Neural-Nexus-IoTrix-2-0/intellicane/hardware/README.md

# Hardware documentation

- [Circuit reference](circuit_diagram.png): C3 pin mapping, required Echo divider, module power and common ground. Confirm actual hardware matches it.
- [Wiring](wiring.md): electrical requirements for the bench prototype.
- [BOM](BOM.md): recorded component costs and future estimates.

The team reports the basic hardware is connected. An enclosure, PCB fabrication files, battery-runtime measurements and physical test records are not supplied here. Do not treat the schematic as evidence that the pictured protection circuitry has already been installed.
