Neural-Nexus-IoTrix-2-0/intellicane/docs/proposals/IntelliCane_Project_Proposal.tex

\documentclass[10pt,a4paper]{article}
\usepackage[utf8]{inputenc}
\usepackage[margin=0.6in,top=0.6in,bottom=0.6in]{geometry}
\usepackage{amsmath}
\usepackage{amssymb}
\usepackage{xcolor}
\usepackage{hyperref}
\usepackage{booktabs}
\usepackage{tabularx}
\usepackage{enumitem}
\usepackage{titlesec}
\usepackage{fancyhdr}
\usepackage{mathptmx}

% Colors
\definecolor{primary}{RGB}{24, 76, 120}     % Navy Blue
\definecolor{secondary}{RGB}{41, 128, 185}  % Slate Blue
\definecolor{darkgray}{RGB}{50, 50, 50}
\definecolor{lightgray}{RGB}{245, 247, 250}

% Hyperref setup
\hypersetup{
    colorlinks=true,
    linkcolor=primary,
    urlcolor=secondary,
    citecolor=primary
}

% Section formatting
\titleformat{\section}{\large\bfseries\color{primary}}{}{0em}{}[\titlerule]
\titlespacing*{\section}{0pt}{7pt}{3pt}
\titleformat{\subsection}{\normalsize\bfseries\color{secondary}}{}{0em}{}
\titlespacing*{\subsection}{0pt}{4pt}{2pt}

% Headers and Footers
\pagestyle{fancy}
\fancyhf{}
\lhead{\footnotesize\textcolor{darkgray}{\textbf{IoTrix 2.0} $|$ Track A: Embedded IoT System}}
\rhead{\footnotesize\textcolor{darkgray}{Team: \textbf{Neural-Nexus} $|$ IntelliCane}}
\lfoot{\footnotesize\textcolor{darkgray}{\href{https://github.com/Neural-Nexus-IoTrix-2-0/intellicane}{github.com/Neural-Nexus-IoTrix-2-0/intellicane}}}
\rfoot{\footnotesize\textcolor{darkgray}{Page \thepage}}
\renewcommand{\headrulewidth}{0.4pt}
\renewcommand{\footrulewidth}{0.4pt}

\setlist{nosep, leftmargin=1.5em}

\begin{document}

% Header Block
\begin{center}
    {\LARGE \textbf{\color{primary} IntelliCane}} \\[0.3em]
    {\large \textbf{Smart Assistive White Cane with Haptic Obstacle Avoidance, Fall Detection, \\ and Companion Mobile App with Caretaker Push Alerts}} \\[0.5em]
    \small
    \textbf{Team Neural-Nexus} \quad$|$\quad \textbf{Track A: Embedded IoT System Development} \quad$|$\quad \textbf{IoTrix 2.0} \\
    \textbf{Members:} Dulnith Liyanage, Thenul Sahansa, Chamith Chethana, Suneth Vidurasa \\
    \textbf{Repository:} \url{https://github.com/Neural-Nexus-IoTrix-2-0/intellicane} \quad$|$\quad \textbf{Submission Date:} 5 October 2026
\end{center}
\vspace{-0.5em}
\hrule height 1pt
\vspace{0.5em}

% Section 1
\section{1. The Problem: Why We Built IntelliCane}
A traditional white cane is great for finding steps and curbs on the ground, but visually impaired people frequently bump into waist- and head-level hazards---such as open car doors, low tree branches, or protruding tables. Worse still, if a user trips, falls, or drops their cane, they can easily get hurt and isolated without any way to call for help. Commercial electronic smart canes attempt to solve this, but they usually cost upwards of \$500 (LKR 150,000+), depend heavily on constant internet connections just to detect hazards, and constantly blast annoying beeps into the user's ears, drowning out vital ambient traffic sounds.

As an undergraduate engineering team, we built \textbf{IntelliCane} to solve these real-world issues directly. For a bench electronics cost of just LKR 2,800, IntelliCane pairs an instant offline hardware reflex on the cane with an accessible Android companion app that keeps caretakers alerted without getting in the user's way.

% Section 2
\section{2. Proposed Solution: How It Works}
We designed IntelliCane around two simple, tightly connected components:
\begin{itemize}
    \item \textbf{Cane Safety Reflex (ESP32-C3):} Operates 100\% offline with a sub-50\,ms loop. An ultrasonic sensor scans ahead up to 4\,m, driving a handle vibration motor via 200\,Hz PWM that kicks in gently at 60\,cm and smoothly intensifies as obstacles get closer (down to 10\,cm). A motion sensor detects sudden drops and falls ($>65^\circ$ tilt or $>2.5\,g$ impact). When a fall occurs, the cane silences its local motor and buzzer so the user isn't startled or panicked, while immediately sending an emergency alert packet over Bluetooth Low Energy (BLE).
    \item \textbf{Companion Android App (\texttt{application/}):} Connects wirelessly over BLE with two tailored modes:
    \begin{itemize}
        \item \textit{Blind User Dashboard:} Clean, accessible status badges, one-tap location sharing, and a collapsible floating terminal window to peek at raw sensor telemetry during testing.
        \item \textit{Caretaker Mode:} Real-time presence indicators, a live tracking map (OSMDroid/ESRI) with a 1-tap user-centering button, and \textbf{instant emergency push notifications (with sound and vibration)} sent straight to the caretaker's phone the second a fall is detected!
    \end{itemize}
\end{itemize}

% Section 3
\section{3. System Architecture \& Data Flow}
\begin{center}
\small
\begin{tabular}{|c|c|c|c|c|}
\hline
\textbf{On the Cane} & $\longrightarrow$ & \textbf{Microcontroller (ESP32-C3)} & $\longrightarrow$ & \textbf{Alerts for the User} \\
Ultrasonic Sensor (Obstacles) & & Fast offline loop (under 50\,ms) & & Vibration Motor (Stronger closer) \\
Motion Sensor (Tilt \& Falls) & & Fall detection logic & & Buzzer (Warning tone; silent on fall) \\
\hline
\multicolumn{5}{c}{$\boldsymbol{\downarrow}$ \textit{Wireless Bluetooth Low Energy (BLE) Link}} \\
\hline
\textbf{Companion Mobile App} & $\longrightarrow$ & \textbf{Cloud Services (Firebase)} & $\longrightarrow$ & \textbf{Caretaker Phone} \\
Blind User Dashboard & & Live phone GPS location & & Real-time tracking map (1-tap centering) \\
Diagnostic Terminal & & Automatic cloud sync & & \textbf{Instant fall alert notification (Sound + Vibrate)} \\
\hline
\end{tabular}
\end{center}

% Section 4
\section{4. Hardware Implementation \& Circuit Design}
We built our prototype around the compact, stamp-sized \textbf{ESP32-C3 SuperMini}:
\begin{itemize}
    \item \textbf{Ultrasonic Ranging (HC-SR04):} Triggered with 10\,$\mu$s pulses on GPIO 0. The Echo pulse connects directly to GPIO 1, which works reliably on the ESP32-C3 bench build and keeps wiring minimal and clean.
    \item \textbf{Motion \& Fall Sensing (GY-521 MPU6050):} Communicates over hardware I2C (SDA: GPIO 4, SCL: GPIO 5) at 100\,kHz. We wrote custom fallback code to handle clone chips and auto-recover from bus lockups.
    \item \textbf{Tactile Vibration Motor:} 3-pin vibration motor module on GPIO 6, modulated at 200\,Hz PWM to provide smooth, gradual distance cues without numbing the user's hand.
    \item \textbf{Audible Warning Buzzer:} Active buzzer on GPIO 7 provides urgent beeps for close obstacles ($<30$\,cm), but automatically stays silent during falls to avoid distressing the user.
\end{itemize}

% Section 5
\section{5. Firmware Architecture \& Control Logic}
Our firmware (\texttt{firmware/core-sensing/core-sensing.ino}) runs without blocking \texttt{delay()} calls, keeping everything responsive:
\begin{itemize}
    \item \textbf{Sensor \& Loop Timing:} Ultrasonic ranging @ 20\,Hz (50\,ms), IMU tilt tracking @ 50\,Hz (20\,ms), motor PWM updates @ 100\,Hz (10\,ms), and BLE telemetry broadcast @ 10\,Hz (100\,ms).
    \item \textbf{Smooth Distance-to-Vibration Mapping:} The motor vibration intensity scales smoothly as obstacle distance $d$ decreases:
    $$\text{PWM Duty} = \text{constrain}\left(255 - \frac{d - d_{\min}}{d_{\max} - d_{\min}} \times (255 - \text{PWM}_{\min}),\ \text{PWM}_{\min},\ 255\right) \quad (d_{\min}=10\,\text{cm},\ d_{\max}=60\,\text{cm})$$
    \item \textbf{Silent Fall Detection \& BLE Broadcast:} If tilt exceeds $65^\circ$ or impact exceeds $2.5\,g$, the cane enters an emergency state, silences local vibration and buzzer sound, and broadcasts \texttt{FALL\_STATE:1} over BLE. Bringing the cane upright ($<30^\circ$) sends \texttt{FALL\_STATE:0} and instantly restores normal navigation.
\end{itemize}

% Section 6
\section{6. Companion Mobile Application (\texttt{application/})}
We built the companion app natively in Kotlin (\texttt{application/}) to bridge IoT sensor data to caretakers:
\begin{itemize}
    \item \textbf{BLE Central Client:} Automatically connects to \texttt{Intelligent-Cane} over Nordic UART Service and decodes live telemetry packets: {\small\texttt{DIST:...|TILT:...|FALL:...|MOTOR:...|BUZZ:...|BLE:...}}.
    \item \textbf{Blind User Dashboard \& Floating Terminal:} Gives blind users high-contrast status cards and location sharing. A collapsible floating terminal button lets us inspect live telemetry during field tests without cluttering the screen.
    \item \textbf{Caretaker Map \& Emergency Centering:} Uses OSMDroid with ESRI map tiles. Caretakers have a dedicated FAB button (\texttt{fabUserLocation}) to jump straight to the user's live coordinates at 18.5x zoom.
    \item \textbf{Automated Fall Notifications \& SMS Alerts:} Uses Firebase Firestore to sync emergency status and cloud functions for automated emergency SMS alerts. When a fall occurs, the caretaker's phone triggers a high-priority system notification (\texttt{showFallAlertNotification}) with sound and vibration, and emergency SMS alerts are dispatched immediately.
\end{itemize}

% Section 7
\section{7. Testing What We Built \& Verification Results}
\begin{itemize}
    \item \textbf{Automated Software Tests (\texttt{tests/proximity\_feedback\_test.cpp}):} 100\% pass across boundary conditions, invalid distances (negative, zero, NaN, $\infty$), smooth PWM ramping, motor polarity flips, and 32-bit timer rollover safety.
    \item \textbf{Bench Distance Checks:} HC-SR04 verified against physical tape measurements from 2\,cm to 250\,cm with $\pm 1.5$\,cm accuracy. Motor vibration engages deterministically at 59.9\,cm and reaches full power at 10\,cm.
    \item \textbf{Tilt Verification:} Calibrated with a digital protractor; the fall trigger trips reliably at $>65^\circ$ and resets within 200\,ms once the cane is upright ($<30^\circ$).
    \item \textbf{Wireless BLE Performance:} Stable 10\,Hz stream to smartphone with $<25$\,ms latency over a 10\,m range. Electronics stayed cool ($<32^\circ$C) during continuous vibration testing.
\end{itemize}

% Section 8
\section{8. Budget \& Cost Feasibility}
We kept prototype costs extremely low by utilizing the smartphone for GPS and cloud connectivity instead of adding expensive dedicated modules:
\begin{center}
\small
\begin{tabularx}{\textwidth}{lXrr}
\toprule
\textbf{Component} & \textbf{Specification / Purpose} & \textbf{Phase 1 Cost (LKR)} & \textbf{Status} \\
\midrule
ESP32-C3 SuperMini & RISC-V 160 MHz MCU with BLE 5.0 \& Native USB-C & 1,400 & Deployed \& Verified \\
HC-SR04 Transceiver & Forward ultrasonic obstacle ranging (2--400 cm) & 450 & Deployed \& Verified \\
GY-521 MPU6050 & 6-Axis Accelerometer / Gyroscope for tilt \& fall & 600 & Deployed \& Verified \\
3-Pin Vibration Motor & Integrated driver module (200 Hz LEDC PWM) & 250 & Deployed \& Verified \\
Piezo Buzzer \& Interconnects & Hazard alert tone \& bench wiring jumpers & 100 & Deployed \& Verified \\
\midrule
\textbf{Total Electronics Cost} & \textbf{Working Bench Prototype} & \textbf{LKR 2,800} & \textbf{Phase 1 Complete} \\
\bottomrule
\end{tabularx}
\end{center}

% Section 9
\section{9. Known Limitations \& How We're Handling Them}
\begin{itemize}
    \item \textbf{Ultrasonic Reflections on Soft Clothes:} Sound waves can scatter on angled soft fabrics beyond 2\,m. \textit{Fix:} We plan to add a compact Time-of-Flight (ToF) laser sensor as a secondary channel in our final build.
    \item \textbf{Breadboard Jumpers:} Prototype jumpers can loosen under prolonged mechanical tapping. \textit{Fix:} We are migrating to a custom soldered 2-layer PCB and a 3D-printed handle before the final competition.
    \item \textbf{Phone Battery Dependency:} If the phone battery dies, remote cloud tracking pauses. \textit{Safety Reflex:} The cane's core obstacle avoidance and local haptics stay 100\% functional offline.
\end{itemize}

% Section 10
\section{10. Roadmap Prior to the Final (17 October 2026)}
\begin{enumerate}
    \item \textbf{Hardware Enclosure \& Custom PCB:} Fabricate a custom PCB and 3D-print an ergonomic cane handle housing with TPU shock damping.
    \item \textbf{Battery Optimization:} Integrate an 18650 Li-ion cell with TP4056 charging circuit and configure ESP32-C3 Light Sleep for $>24$\,hour runtime.
    \item \textbf{Secondary ToF Laser Sensor:} Add a compact Time-of-Flight laser ranging sensor to supplement ultrasonic detection in crowded spaces.
\end{enumerate}

\vspace{0.4em}
\noindent\textbf{GitHub Repository Link:} \url{https://github.com/Neural-Nexus-IoTrix-2-0/intellicane}
\end{document}
