Neural-Nexus-IoTrix-2-0/intellicane/docs/proposals/One_Page_Technical_Proposal.tex

\documentclass[10pt,a4paper]{article}
\usepackage[utf8]{inputenc}
\usepackage[margin=0.55in,top=0.48in,bottom=0.48in]{geometry}
\usepackage{xcolor}
\usepackage{hyperref}
\usepackage{booktabs}
\usepackage{tabularx}
\usepackage{enumitem}
\usepackage{titlesec}
\usepackage{fancyhdr}
\usepackage{mathptmx}

\definecolor{primary}{RGB}{20, 70, 115}
\definecolor{secondary}{RGB}{40, 120, 180}
\definecolor{darkgray}{RGB}{50, 50, 50}

\hypersetup{colorlinks=true, linkcolor=primary, urlcolor=secondary}

\titleformat{\section}{\normalsize\bfseries\color{primary}}{}{0em}{}[\titlerule]
\titlespacing*{\section}{0pt}{5pt}{3pt}

\pagestyle{fancy}
\fancyhf{}
\lhead{\footnotesize\textcolor{darkgray}{\textbf{IoTrix 2.0} $|$ Track A: Embedded IoT System}}
\rhead{\footnotesize\textcolor{darkgray}{Team: \textbf{Neural-Nexus} $|$ \textbf{IntelliCane}}}
\lfoot{\footnotesize\textcolor{darkgray}{\href{https://github.com/Neural-Nexus-IoTrix-2-0/intellicane}{github.com/Neural-Nexus-IoTrix-2-0/intellicane}}}
\rfoot{\footnotesize\textcolor{darkgray}{One-Page Project Proposal}}
\renewcommand{\headrulewidth}{0.4pt}
\renewcommand{\footrulewidth}{0.4pt}

\setlist{nosep, leftmargin=1.3em, itemsep=2pt}

\begin{document}

\begin{center}
    {\Large \textbf{\color{primary} IntelliCane: Smart Assistive White Cane}} \\[0.25em]
    {\normalsize \textbf{Obstacle Avoidance, Fall Detection, and Companion Mobile App for Caretakers}} \\[0.3em]
    \footnotesize
    \textbf{Team Neural-Nexus} \quad$|$\quad \textbf{Track A: Embedded IoT System} \quad$|$\quad \textbf{IoTrix 2.0 Semi-Final (5 Oct 2026)} \\
    \textbf{Members:} Dulnith Liyanage, Thenul Sahansa, Chamith Chethana, Suneth Vidurasa \quad$|$\quad \textbf{Bench Prototype Cost:} LKR 2,800 \\
    \textbf{Project Repository:} \url{https://github.com/Neural-Nexus-IoTrix-2-0/intellicane}
\end{center}
\vspace{-0.5em}
\hrule height 0.8pt
\vspace{0.4em}

\section{1. The Problem: Why We Built IntelliCane}
A traditional white cane is great for finding steps and curbs on the ground, but it cannot warn visually impaired people about waist- or head-level hazards---like open car doors, tree branches, or table corners. In addition, if a user trips and falls, they can easily get hurt and isolated without any way to alert family. Existing smart canes cost upwards of \$500 (LKR 150,000+), depend on a reliable internet connection, or blast annoying beeps that make it hard to hear surrounding traffic. As undergraduate students, we wanted to build something genuinely affordable, practical, and dependable that works offline while keeping caretakers in the loop.

\section{2. How IntelliCane Works}
IntelliCane is built in two simple, connected parts:
\begin{itemize}
    \item \textbf{Smart Cane Hardware (ESP32-C3):} The cane works completely on its own without needing a phone or internet. An ultrasonic sensor scans ahead up to 4\,m. A small motor in the handle vibrates gently when an obstacle is 60\,cm away, and vibrates progressively stronger as you get closer (down to 10\,cm). A motion sensor detects sudden falls or drops. During a fall, the cane stays quiet locally (no loud buzzing or alarm to panic the user) and instantly transmits an emergency alert over Bluetooth.
    \item \textbf{Companion Mobile App (\texttt{application/}):} Connects to the cane over Bluetooth Low Energy with two modes:
    \begin{itemize}
        \item \textit{Blind User Mode:} Clean high-contrast screen showing connection status, a 1-tap location sharing button, and a collapsible diagnostic terminal for testing.
        \item \textit{Caretaker Mode:} Shows the user's live status, displays their real-time location on an interactive map with a quick re-center button, and \textbf{sends instant emergency push notifications (with sound and vibration)} to the caretaker's phone the moment a fall occurs!
    \end{itemize}
\end{itemize}

\section{3. System Overview}
\vspace{-0.2em}
\begin{center}
\footnotesize
\begin{tabular}{|l|c|l|c|l|}
\hline
\textbf{On the Cane} & $\rightarrow$ & \textbf{Microcontroller (ESP32-C3)} & $\rightarrow$ & \textbf{Alerts for the User} \\
Ultrasonic Sensor (Obstacles) & & Fast offline loop (under 50\,ms) & & Vibration Motor (Stronger as you get closer) \\
Motion Sensor (Tilt \& Falls) & & Fall detection logic & & Buzzer (Warning tone; silent during falls) \\
\hline
\multicolumn{5}{|c|}{\textit{Wireless Bluetooth Low Energy (BLE) Link}} \\
\hline
\textbf{Companion Mobile App} & $\rightarrow$ & \textbf{Cloud Services (Firebase)} & $\rightarrow$ & \textbf{Caretaker Phone} \\
Blind User Dashboard & & Live phone GPS location & & Real-time tracking map (1-tap centering) \\
Diagnostic Terminal & & Automatic cloud sync & & \textbf{Instant fall alert notification (Sound + Vibrate)} \\
\hline
\end{tabular}
\end{center}
\vspace{-0.4em}

\section{4. What We Have Built \& Verified}
\begin{itemize}
    \item \textbf{Working Hardware Prototype:} Assembled and tested with the ESP32-C3 controller, ultrasonic sensor (Echo wired directly to GPIO 1), motion sensor, handle vibration motor, and buzzer for just LKR 2,800.
    \item \textbf{Intuitive Handle Vibration:} The handle vibrates smoothly between 60\,cm and 10\,cm. It stays off past 60\,cm so the user's hand does not get tired.
    \item \textbf{Silent Fall Protection:} If the cane tilts past $65^\circ$ or takes a hard drop, it keeps quiet on the cane and immediately alerts the phone over Bluetooth. Standing the cane back up ($<30^\circ$) automatically clears the emergency and resumes normal guidance.
    \item \textbf{Caretaker Alerts \& Automated SMS:} Built in Kotlin (\texttt{application/}) with a live tracking map, vibrating emergency push alerts, and automated SMS emergency alerts to emergency contacts the moment a fall is detected.
    \item \textbf{Bench Testing:} Verified ultrasonic distance accuracy with a physical tape measure from 2\,cm to 2.5\,m ($\pm 1.5$\,cm accuracy). Tested fall detection with a digital protractor and ran software unit tests to ensure calculations never crash or freeze.
\end{itemize}

\section{5. Components \& Cost (Total: LKR 2,800)}
\begin{itemize}
    \item \textbf{Cane Electronics:} ESP32-C3 SuperMini (LKR 1,400), Ultrasonic Sensor (LKR 450), Motion Sensor (LKR 600), Vibration Motor (LKR 250), Buzzer \& Jumpers (LKR 100). \textbf{Total Cost: LKR 2,800}.
    \item \textbf{Software Tools:} C++ firmware (Arduino-ESP32), Android app in Kotlin (\texttt{application/}), Firebase cloud database, OpenStreetMap / ESRI live maps.
\end{itemize}

\section{6. Known Limitations \& Roadmap to the Final (17 October 2026)}
\begin{itemize}
    \item \textbf{Current Limitations \& Solutions:} Soft angled clothing can sometimes scatter ultrasound beyond 2\,m (we will add a compact laser sensor for the final). Breadboard jumper wires can loosen during heavy movement (we are making a custom soldered PCB and 3D-printed handle).
    \item \textbf{Next Steps for the Final:} (1) Build the custom soldered PCB and ergonomic handle with TPU shock damping, (2) Add a rechargeable 18650 battery with charge protection for all-day runtime, and (3) Add a secondary Time-of-Flight laser sensor.
\end{itemize}

\end{document}
