Neural-Nexus-IoTrix-2-0/intellicane/docs/Neural-Nexus.pdf

IoTrix 2.0 | Track A: Embedded IoT System | Team: Neural-Nexus | IntelliCane

# IntelliCane

Smart Assistive White Cane with Haptic Obstacle Avoidance, Fall Detection, and Companion Mobile App with Caretaker Push Alerts

Team Neural-Nexus | | Track A: Embedded IoT System Development | | IoTrix 2.0
Members: Dulnith Liyanage, Thenul Sahansa, Chamith Chethana, Suneth Vidurasa
Repository: https://github.com/Neural-Nexus-IoTrix-2-0/intellicane | Submission Date: 5 October 2026

### 1. The Problem: Why We Built IntelliCane

A traditional white cane is great for finding steps and curbs on the ground, but visually impaired people frequently bump into waist- and head-level hazards—such as open car doors, low tree branches, or protruding tables. Worse still, if a user trips, falls, or drops their cane, they can easily get hurt and isolated without any way to call for help. Commercial electronic smart canes attempt to solve this, but they usually cost upwards of $500 (LKR 150,000+), depend heavily on constant internet connections just to detect hazards, and constantly blast annoying beeps into the user’s ears, drowning out vital ambient traffic sounds.
As an undergraduate engineering team, we built IntelliCane to solve these real-world issues directly. For a bench electronics cost of just LKR 2,800, IntelliCane pairs an instant offline hardware reflex on the cane with an accessible Android companion app that keeps caretakers alerted without getting in the user’s way.

### 2. Proposed Solution: How It Works

We designed IntelliCane around two simple, tightly connected components:
- Cane Safety Reflex (ESP32-C3): Operates 100% offline with a sub-50 ms loop. An ultrasonic sensor scans ahead up to 4 m, driving a handle vibration motor via 200 Hz PWM that kicks in gently at 60 cm and smoothly intensifies as obstacles get closer (down to 10 cm). A motion sensor detects sudden drops and falls (> 65◦
tilt or > 2.5g impact). When a fall occurs, the cane silences its local motor and buzzer so the user isn’t startled or panicked, while immediately sending an emergency alert packet over Bluetooth Low Energy (BLE).
- Companion Android App (application/): Connects wirelessly over BLE with two tailored modes:
– Blind User Dashboard: Clean, accessible status badges, one-tap location sharing, and a collapsible floating terminal window to peek at raw sensor telemetry during testing.
– Caretaker Mode: Real-time presence indicators, a live tracking map (OSMDroid/ESRI) with a 1-tap user-centering button, and instant emergency push notifications (with sound and vibration) sent straight to the caretaker’s phone the second a fall is detected!

### 3. System Architecture & Data Flow

On the Cane | −→ | Microcontroller (ESP32-C3) | −→ | Alerts for the User
Ultrasonic Sensor (Obstacles) | | Fast offline loop (under 50 ms) | | Vibration Motor (Stronger closer)
Motion Sensor (Tilt & Falls) | | Fall detection logic | | Buzzer (Warning tone; silent on fall)
↓ Wireless Bluetooth Low Energy (BLE) Link
Companion Mobile App | −→ | Cloud Services (Firebase) | −→ | Caretaker Phone
Blind User Dashboard | | Live phone GPS location | | Real-time tracking map (1-tap centering)
Diagnostic Terminal | | Automatic cloud sync | | Instant fall alert notification (Sound + Vibrate)

### 4. Hardware Implementation & Circuit Design

We built our prototype around the compact, stamp-sized ESP32-C3 SuperMini:
- Ultrasonic Ranging (HC-SR04): Triggered with 10 µs pulses on GPIO 0. The Echo pulse connects directly to GPIO 1, which works reliably on the ESP32-C3 bench build and keeps wiring minimal and clean.
- Motion & Fall Sensing (GY-521 MPU6050): Communicates over hardware I2C (SDA: GPIO 4, SCL: GPIO 5) at 100 kHz. We wrote custom fallback code to handle clone chips and auto-recover from bus lockups.
- Tactile Vibration Motor: 3-pin vibration motor module on GPIO 6, modulated at 200 Hz PWM to provide smooth, gradual distance cues without numbing the user’s hand.
- Audible Warning Buzzer: Active buzzer on GPIO 7 provides urgent beeps for close obstacles (< 30 cm), but automatically stays silent during falls to avoid distressing the user.

### 5. Firmware Architecture & Control Logic

Our firmware (firmware/core-sensing/core-sensing.ino) runs without blocking delay() calls, keeping everything responsive:
- Sensor & Loop Timing: Ultrasonic ranging @ 20 Hz (50 ms), IMU tilt tracking @ 50 Hz (20 ms), motor PWM updates @ 100 Hz (10 ms), and BLE telemetry broadcast @ 10 Hz (100 ms).
- Smooth Distance-to-Vibration Mapping: The motor vibration intensity scales smoothly as obstacle distance d decreases: PWM Duty = constrain
255−
| | d −dmin
| | dmax −dmin

×(255−PWMmin), PWMmin, 255 (dmin = 10cm, dmax = 60cm)

- Silent Fall Detection & BLE Broadcast: If tilt exceeds 65◦ or impact exceeds 2.5g, the cane enters an emergency state, silences local vibration and buzzer sound, and broadcasts FALL STATE:1 over BLE. Bringing the cane upright (< 30◦
) sends
FALL STATE:0 and instantly restores normal navigation.
github.com/Neural-Nexus-IoTrix-2-0/intellicane | Page 1

IoTrix 2.0 | Track A: Embedded IoT System | Team: Neural-Nexus | IntelliCane

### 6. Companion Mobile Application (application/)

We built the companion app natively in Kotlin (application/) to bridge IoT sensor data to caretakers:
- BLE Central Client: Automatically connects to Intelligent-Cane over Nordic UART Service and decodes live telemetry
packets: DIST:...|TILT:...|FALL:...|MOTOR:...|BUZZ:...|BLE:....
- Blind User Dashboard & Floating Terminal: Gives blind users high-contrast status cards and location sharing. A collapsible floating terminal button lets us inspect live telemetry during field tests without cluttering the screen.
- Caretaker Map & Emergency Centering: Uses OSMDroid with ESRI map tiles. Caretakers have a dedicated FAB button (fabUserLocation) to jump straight to the user’s live coordinates at 18.5x zoom.
- Automated Fall Notifications & SMS Alerts: Uses Firebase Firestore to sync emergency status and cloud functions for automated emergency SMS alerts. When a fall occurs, the caretaker’s phone triggers a high-priority system notification (showFallAlertNotification) with sound and vibration, and emergency SMS alerts are dispatched immediately.

### 7. Testing What We Built & Verification Results

- Automated Software Tests (tests/proximity feedback test.cpp): 100% pass across boundary conditions, invalid distances (negative, zero, NaN, ∞), smooth PWM ramping, motor polarity flips, and 32-bit timer rollover safety.
- Bench Distance Checks: HC-SR04 verified against physical tape measurements from 2 cm to 250 cm with ±1.5 cm accuracy. Motor vibration engages deterministically at 59.9 cm and reaches full power at 10 cm.
- Tilt Verification: Calibrated with a digital protractor; the fall trigger trips reliably at > 65◦
and resets within 200 ms once the cane is upright (< 30◦
).
- Wireless BLE Performance: Stable 10 Hz stream to smartphone with < 25 ms latency over a 10 m range. Electronics stayed cool (< 32◦C) during continuous vibration testing.

### 8. Budget & Cost Feasibility

We kept prototype costs extremely low by utilizing the smartphone for GPS and cloud connectivity instead of adding expensive dedicated modules:

Component | Specification / Purpose | Phase 1 Cost (LKR) | Status
ESP32-C3 SuperMini | RISC-V 160 MHz MCU with BLE 5.0 & Native USB-C | 1,400 | Deployed & Verified
HC-SR04 Transceiver | Forward ultrasonic obstacle ranging (2–400 cm) | 450 | Deployed & Verified
GY-521 MPU6050 | 6-Axis Accelerometer / Gyroscope for tilt & fall | 600 | Deployed & Verified
3-Pin Vibration Motor | Integrated driver module (200 Hz LEDC PWM) | 250 | Deployed & Verified
Piezo Buzzer & Interconnects | Hazard alert tone & bench wiring jumpers | 100 | Deployed & Verified
Total Electronics Cost | Working Bench Prototype | LKR 2,800 | Phase 1 Complete

### 9. Known Limitations & How We’re Handling Them

- Ultrasonic Reflections on Soft Clothes: Sound waves can scatter on angled soft fabrics beyond 2 m. Fix: We plan to add a compact Time-of-Flight (ToF) laser sensor as a secondary channel in our final build.
- Breadboard Jumpers: Prototype jumpers can loosen under prolonged mechanical tapping. Fix: We are migrating to a custom soldered 2-layer PCB and a 3D-printed handle before the final competition.
- Phone Battery Dependency: If the phone battery dies, remote cloud tracking pauses. Safety Reflex: The cane’s core obstacle avoidance and local haptics stay 100% functional offline.

### 10. Roadmap Prior to the Final (17 October 2026)

1. Hardware Enclosure & Custom PCB: Fabricate a custom PCB and 3D-print an ergonomic cane handle housing with TPU shock damping.
2. Battery Optimization: Integrate an 18650 Li-ion cell with TP4056 charging circuit and configure ESP32-C3 Light Sleep for > 24 hour runtime.
3. Secondary ToF Laser Sensor: Add a compact Time-of-Flight laser ranging sensor to supplement ultrasonic detection in crowded spaces.

GitHub Repository Link: https://github.com/Neural-Nexus-IoTrix-2-0/intellicane

github.com/Neural-Nexus-IoTrix-2-0/intellicane | Page 2
