Neural-Nexus-IoTrix-2-0/intellicane/docs/README.md

# Documentation Index

- [One-Page Technical Proposal](../ONE_PAGE_TECHNICAL_PROPOSAL.md) — Standardized 8-section technical progress report for IoTrix 2.0 (PDF: [`ONE_PAGE_TECHNICAL_PROPOSAL.pdf`](../ONE_PAGE_TECHNICAL_PROPOSAL.pdf))
- [Project Proposal](proposals/Intelligent_Cane_Proposal.md) — Comprehensive project proposal (Submission PDF: [`output/semifinal/Neural-Nexus.pdf`](../output/semifinal/Neural-Nexus.pdf))
- [System Architecture](architecture.md) — Block diagrams, data flow, timing characteristics, and offline/online subsystem division
- [Architectural Decision Records (ADRs)](decisions.md) — Engineering rationale for hardware selection, direct drive, and BLE telemetry
- [Demonstration & Defense Guide](IoTrix_SemiFinal_Defense_and_Demo_Guide.md) — Speaking schedule, physical test routines, and model answers to judges' questions
- [Software Validation Log](test-logs/2026-10-05-software-validation.md) — Host unit testing and ESP32-C3 firmware build verification records

Exported deliverables are in `output/semifinal/` (Slide deck: `Intelligent_Cane_Semifinal.pptx`, Proposal: `Neural-Nexus.pdf`, Progress Sheet: `Technical_Progress_Sheet.pdf`).
