Neural-Nexus-IoTrix-2-0/intellicane/hardware/circuit_diagram.png

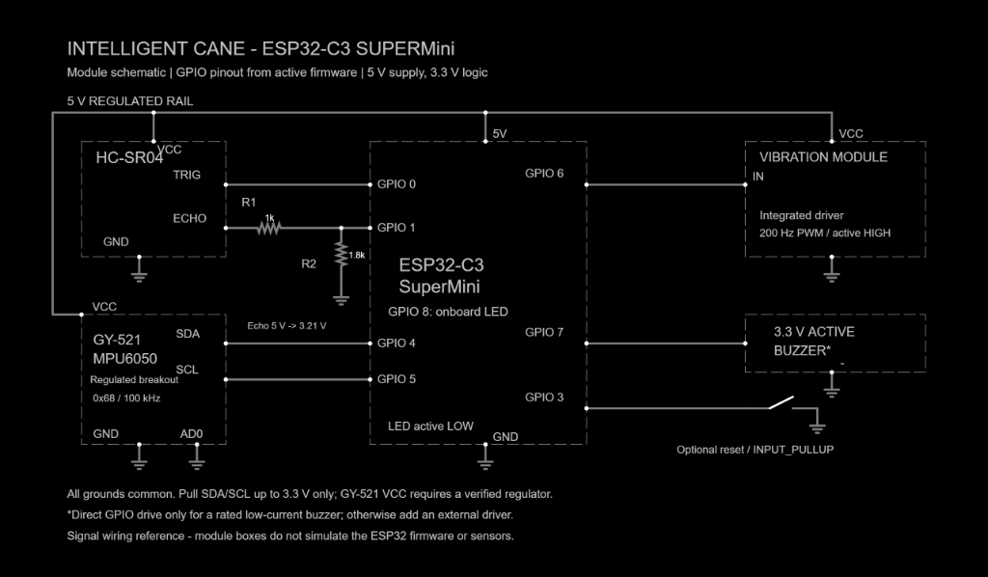
hardware/circuit_diagram.png
