Neural-Nexus-IoTrix-2-0/intellicane/3d_files/04_Clamp_fixed_half.STL

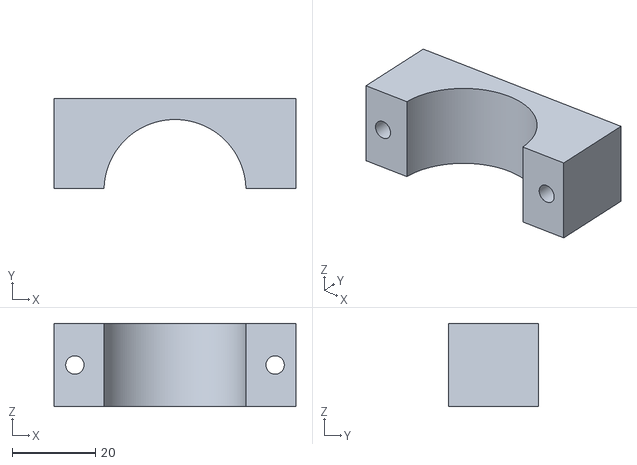
[picture p2: CAD file, 2026-10-15]
3d_files/04_Clamp_fixed_half.STL
58.0 x 21.5 x 20.0
