Neural-Nexus-IoTrix-2-0/intellicane/3d_files/02_Front_lid.STL

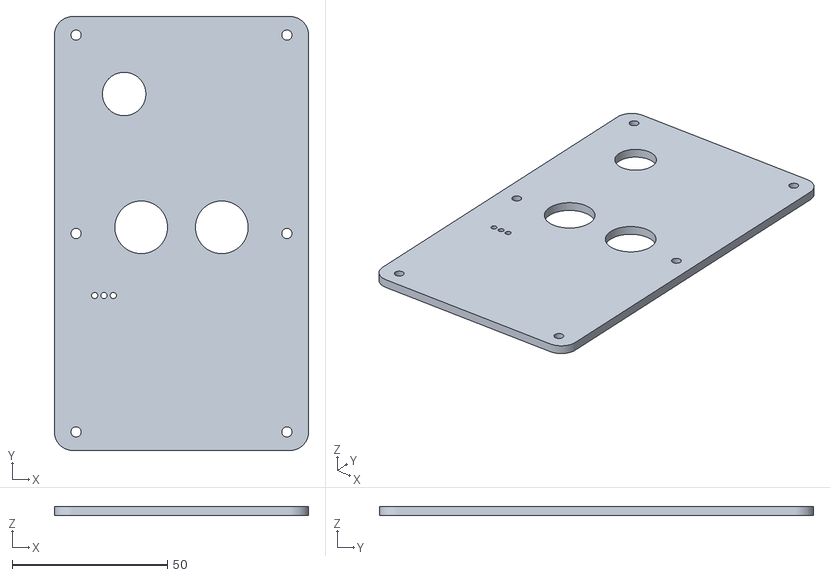
[picture p3: CAD file, 2026-10-15]
3d_files/02_Front_lid.STL
82.0 x 140.0 x 3.00
