Neural-Nexus-IoTrix-2-0/intellicane/(commit log)

2026-10-01 feat(core-sensing): implement phase 1 sensor drivers, haptic PWM, and safety controller
2026-10-01 docs(hardware): add wiring schematics, driver circuits, and bill of materials
2026-10-04 feat(hardware): migrate core sensing to ESP32-C3 SuperMini and HC-SR04
    - Switch primary MCU to ultra-compact ESP32-C3 SuperMini with native USB-C CDC
    - Replace ToF with HC-SR04 ultrasonic sensor (Trig: GPIO 0, Echo: GPIO 1 via divider)
    - Configure 200 Hz LEDC PWM on GPIO 6 for vibration motor via 2N2222 transistor
    - Universal active/passive buzzer support on GPIO 7 with startup self-test
    - MPU6050 6-axis IMU on hardware I2C (GPIO 4 SDA, GPIO 5 SCL)
    - Emergency pushbutton on GPIO 3 (INPUT_PULLUP) and onboard LED on GPIO 8
    - Archive legacy dual-ToF PlatformIO architecture to firmware/archived-dual-tof/
    - Add Wokwi simulation workspace under simulation/wokwi/
    - Update BOM, wiring schematics, AD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
    [BuzzerAlert.cpp, BuzzerAlert.h, CaneController.cpp, CaneController.h, DownwardSensor.cpp, DownwardSensor.h, ForwardSensor.cpp, ForwardSensor.h]
2026-10-04 docs(hardware): document direct GPIO motor drive and direct ultrasonic echo connections
    - Update hardware/wiring.md with bench direct wiring diagrams for vibration motor (GPIO 6) and HC-SR04 Echo (GPIO 1)
    - Preserve production driver circuits (2N2222 transistor + flyback diode, resistor voltage divider) as recommended reference designs
    - Update hardware/BOM.md to reflect omitted discrete components for Phase 1 bench build (~LKR 9,500)
    - Update docs/architecture.md and docs/decisions.md (ADR-006) with direct wiring rationale and production migration path
    - Update firmware/core-sensing/README.md, core-sensing.ino comments, and root README.md pin mapping
    [core-sensing.ino]
2026-10-04 docs(hardware): note pushbutton omission and automatic upright fall reset
    - Mark pushbutton on GPIO 3 as optional / omitted on current bench prototype
    - Document automatic upright orientation reset for the fall alarm (< 30° tilt)
    - Update BOM.md Phase 1 prototype cost to ~LKR 9,450
    - Update wiring.md, decisions.md (ADR-006), architecture.md, core-sensing.ino comments, and root README.md
    [core-sensing.ino]
2026-10-04 fix(firmware): add dual I2C address detection (0x68/0x69) and timeout recovery for MPU6050
    [core-sensing.ino]
2026-10-04 feat(hardware): support 3-pin vibration motor module and 5V MPU6050 power
    - Update core-sensing.ino with configurable motor polarity (MOTOR_ACTIVE_LOW) and setMotorPwm helper
    - Document 3-pin vibration motor module (VCC to 5V, GND to GND, IN to GPIO 6) across wiring.md and README.md
    - Document MPU6050 5V VCC connection to power onboard 3.3V LDO regulator cleanly
    - Update BOM.md for 3-pin vibration motor module (~LKR 9,550 total)
    [core-sensing.ino]
2026-10-04 fix(firmware): limit vibration to under 60cm and ramp proximity alerts
    [ProximityFeedback.h, core-sensing.ino, proximity_feedback_test.cpp]
2026-10-04 docs: adopt BLE smartphone geolocation bridging and update Phase 1 BOM to Rs. 2800 (ADR-007)
2026-10-04 fix(firmware): add direct register MPU driver, multi-pin scanner, and auto-reconnect
    [core-sensing.ino]
2026-10-04 feat(firmware): stream serial monitor output over Bluetooth using Nordic UART Service (NUS)
2026-10-04 docs(hardware): add official ESP32-C3 SuperMini circuit diagram schematic
2026-10-05 docs: update proposal to reflect direct ultrasonic sensor wiring without voltage divider
2026-10-05 fix(firmware): silence buzzer and vibration on fall while preserving BLE notification dispatch
    [core-sensing.ino]
2026-10-12 docs(hardware): add finals purchase list and power guide PDF
2026-10-13 feat(ai-vision): implement ESP32-CAM firmware and AI voice scene description service
2026-10-13 perf(cam-module): add real-time MJPEG live stream, instant frame capture, and dynamic resolution control
2026-10-14 refactor: format code and add auto-retry for Gemini API 503 errors in camera module
2026-10-14 feat(hardware): integrate dual ultrasonic, TOF10120 ground drop-off, dual-zone haptics, and camera trigger
2026-10-14 feat(sensing): use TOF10120 laser sensor instead of ultrasonic sensor
2026-10-14 docs(wiring): add TOF10120 6-wire harness color mapping
2026-10-14 feat(sensing): multi-modal fusion combining TOF10120 laser and ultrasonic sensors
2026-10-14 refactor(sensing): configure for single ultrasonic sensor and TOF10120 laser sensor
2026-10-14 feat(hardware): power ESP32-CAM from C3, remove pushbutton and GPIO8 LED dependencies
2026-10-14 fix(firmware): resolve passive buzzer silence, motor coil whine, and dual haptic actuation
2026-10-14 feat(firmware): enforce constant 800 Hz buzzer tone with proximity-accelerated pulse cadence
2026-10-14 fix(firmware): optimize motor PWM carrier to 200 Hz and add haptic diagnostic routine
2026-10-14 feat(audio/ble): switch buzzer to low-frequency 520 Hz high-volume tone and align BLE MAC with mobile app
2026-10-14 fix(cam): fix browser cross-port stream render with instant frame fallback
2026-10-14 Added camera setup to the mobile application
2026-10-14 fix(cam): optimize OV2640 xclk clock, frame grab mode, and snapshot lock to eliminate capture timeout
2026-10-14 fix(cam): disable brownout detector and add zero-RF cane mode to eliminate power sag
2026-10-15 feat(button): add physical push button on GPIO 3 and onboard BOOT button fallback for AI camera capture
2026-10-15 Removed the Discribe surroundings button Co-authored-by: dulnith-liyanage <dnethmiraliyanage@gmail.com>
2026-10-16 Use single GPIO 2 motor for all proximity feedback
